JuanMShalvarez/IQ-TX/Hardware/Kicad Files/IQ_TX/MAX660CSA+.stp

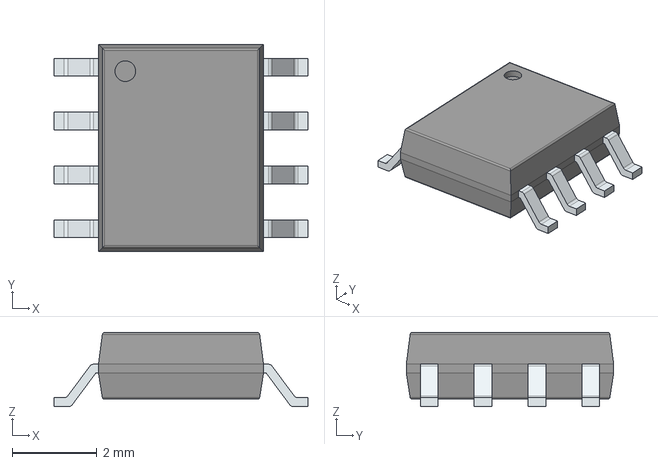
[picture p1: CAD file, 2026-11-06]
Hardware/Kicad Files/IQ_TX/MAX660CSA+.stp
6.00 x 4.90 x 1.75 mm
PinsArrayLR
