JuanMShalvarez/IQ-TX/Hardware/Kicad Files/IQ_TX/ADRF6755ACPZ.stp

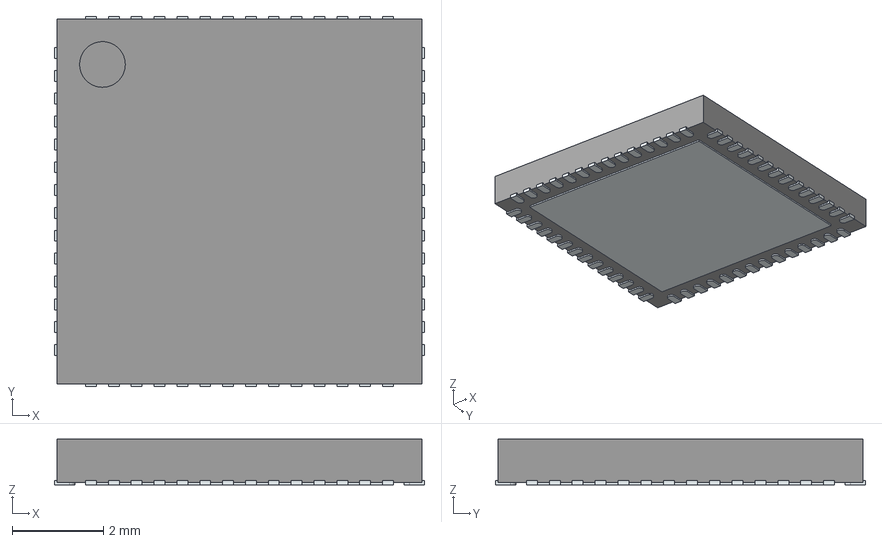
[picture p2: CAD file, 2026-11-06]
Hardware/Kicad Files/IQ_TX/ADRF6755ACPZ.stp
8.10 x 8.10 x 1.00 mm
ThermalPin
PinsArrayLR
PinsArrayTB
