JuanMShalvarez/IQ-TX/Hardware/Kicad Files/IQ_TX/SMARA_CONNECTOR.stp

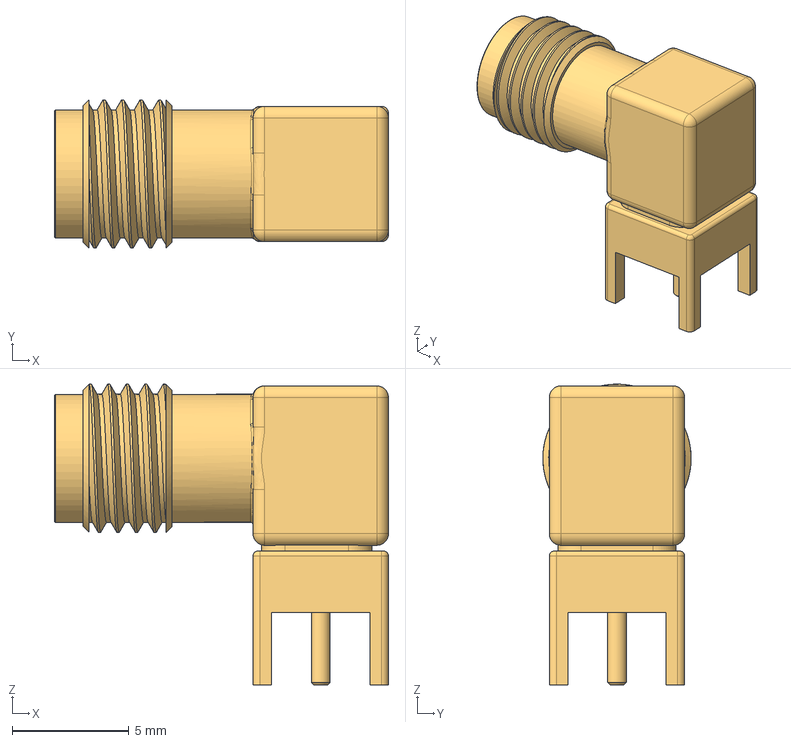
[picture p3: CAD file, 2026-11-06]
Hardware/Kicad Files/IQ_TX/SMARA_CONNECTOR.stp
14.3 x 6.35 x 12.9 mm
