JuanMShalvarez/IQ-TX/Hardware/Kicad Files/IQ_TX.kicad_pcb

## KiCad design Hardware/Kicad Files/IQ_TX.kicad_pcb (2026-10-28)

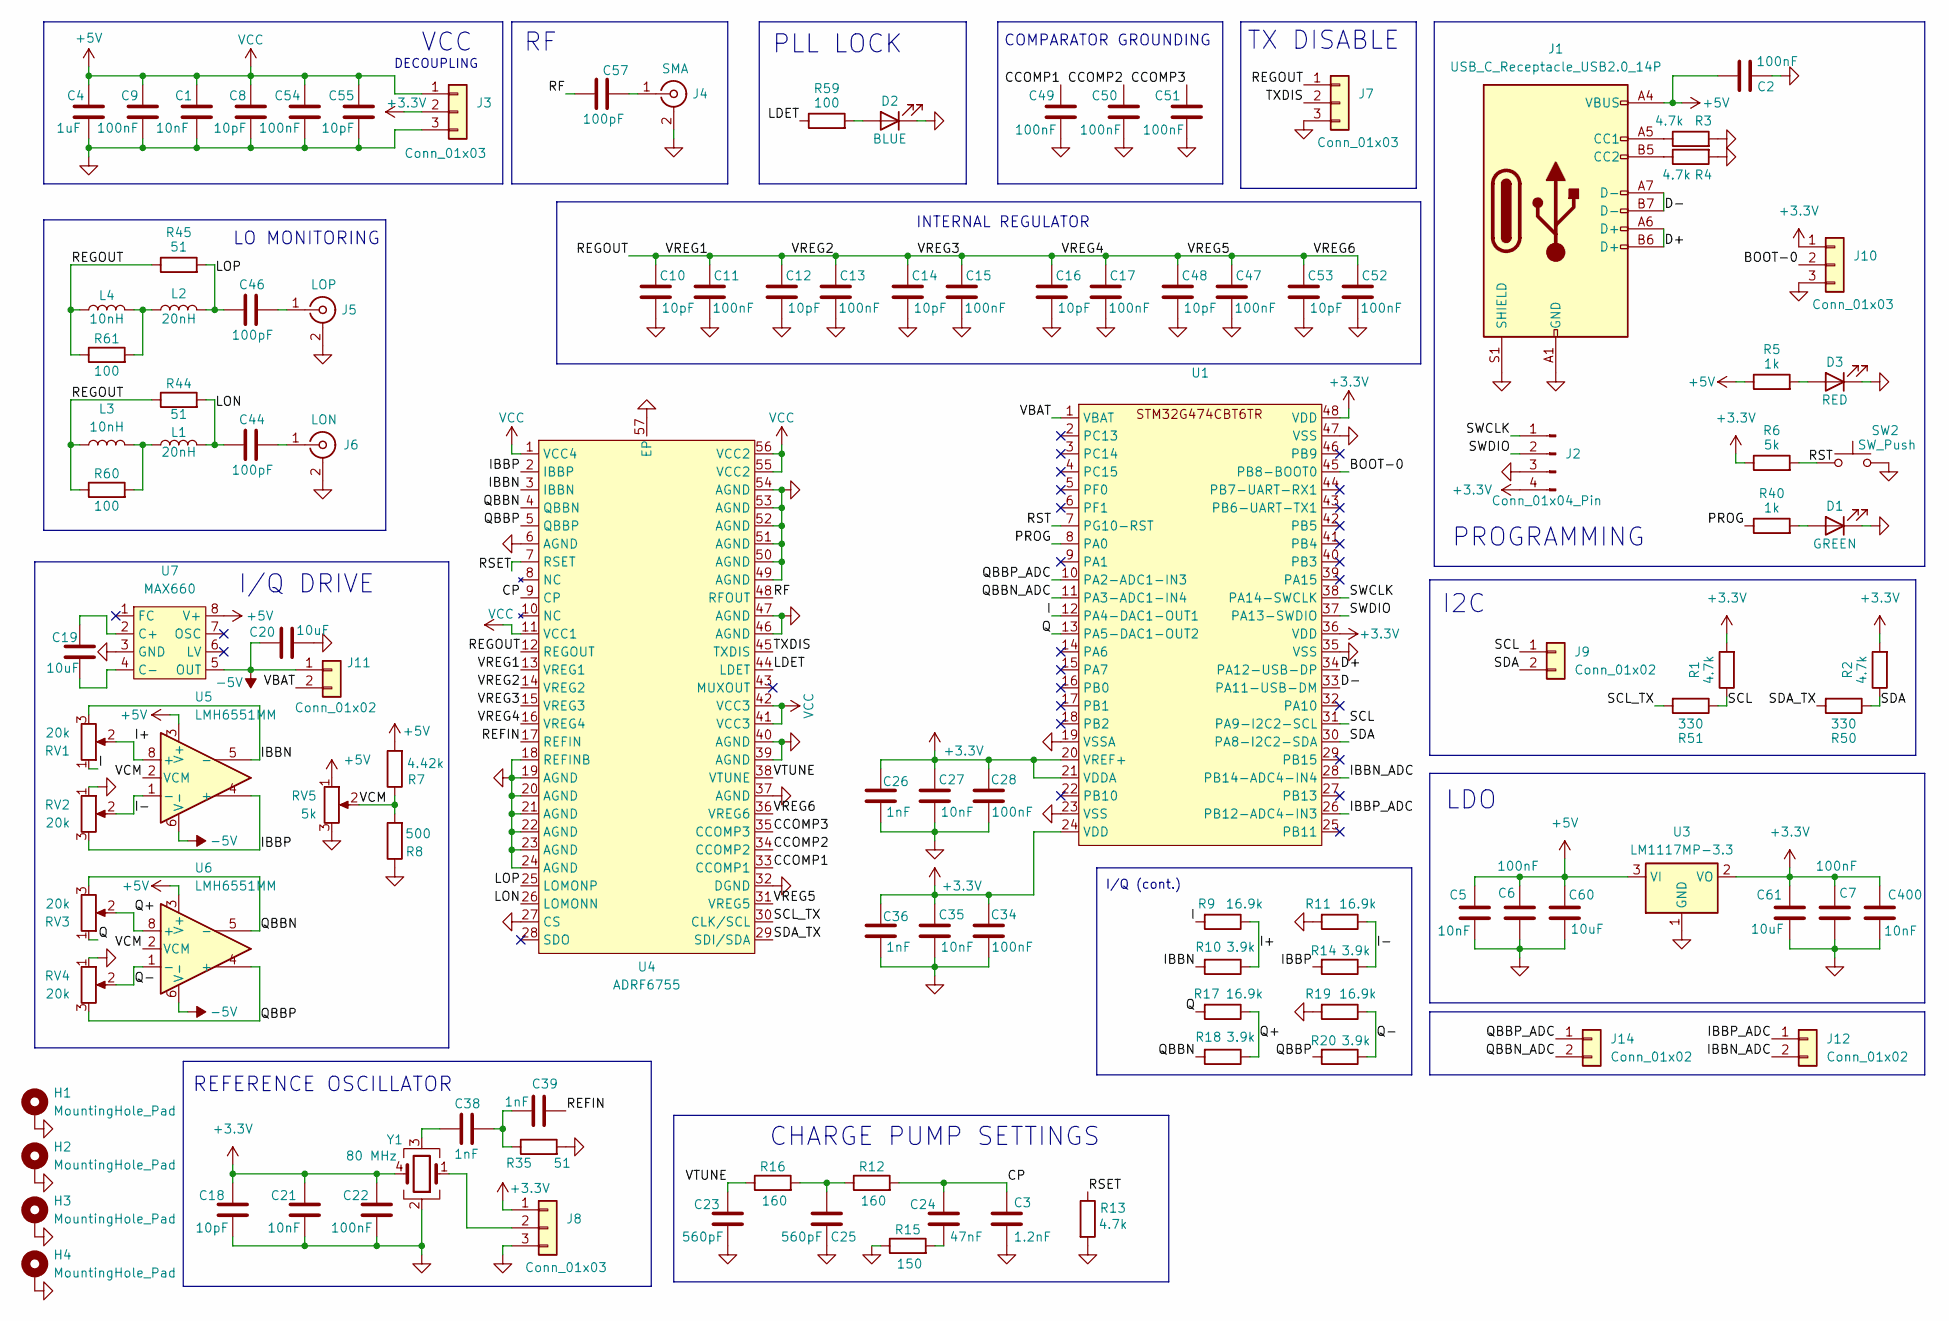
[picture p4: schematic IQ_TX.kicad_sch, I/Q TX Module]

Parts:
C1, C5, C21, C27, C35, C400: 10nF; C_0603_1608Metric
C2, C6, C7, C9, C11, C13, C15, C17, C22, C28, C34, C47, C49, C50, C51, C52, C54: 100nF; C_0603_1608Metric
C3: 1.2nF; C_0603_1608Metric
C4: 1uF; C_0603_1608Metric
C8, C10, C12, C14, C16, C18, C48, C53, C55: 10pF; C_0603_1608Metric
C19, C20: 10uF; C_0603_1608Metric
C23, C25: 560pF; C_0603_1608Metric
C24: 47nF; C_0603_1608Metric
C26, C36, C38, C39: 1nF; C_0603_1608Metric
C44, C46, C57: 100pF; C_0603_1608Metric
C60, C61: 10uF; CP_Elec_4x4.5
D1: GREEN; LED_0603_1608Metric
D2: BLUE; LED_0603_1608Metric
D3: RED; LED_0603_1608Metric
H1, H2, H3, H4: MountingHole_Pad; MountingHole_3.2mm_M3_Pad_Via
J1: USB_C_Receptacle_USB2.0_14P; USB_C_Receptacle_HRO_TYPE-C-31-M-12
J2: Conn_01x04_Pin; PinHeader_1x04_P2.54mm_Vertical
J3, J7, J8, J10: Conn_01x03; PinHeader_1x03_P2.54mm_Vertical
J4: SMA; SMA_Amphenol_901-144_Vertical
J5: LOP; SMA_Amphenol_901-144_Vertical
J6: LON; SMA_Amphenol_901-144_Vertical
J9, J11, J12, J14: Conn_01x02; PinHeader_1x02_P2.54mm_Vertical
L1, L2: 20nH; L_0603_1608Metric
L3, L4: 10nH; L_0603_1608Metric
R1, R2, R3, R4, R13: 4.7k; R_0603_1608Metric
R5, R40: 1k; R_0603_1608Metric
R6: 5k; R_0603_1608Metric
R7: 4.42k; R_0603_1608Metric
R8: 500; R_0603_1608Metric
R9, R11, R17, R19: 16.9k; R_0603_1608Metric
R10, R14, R18, R20: 3.9k; R_0603_1608Metric
R12, R16: 160; R_0603_1608Metric
R15: 150; R_0603_1608Metric
R35, R44, R45: 51; R_0603_1608Metric
R50, R51: 330; R_0603_1608Metric
R59, R60, R61: 100; R_0603_1608Metric
RV1, RV2, RV3, RV4: 20k; Potentiometer_Bourns_3386W_Horizontal
RV5: 5k; Potentiometer_Bourns_3386W_Horizontal
SW2: SW_Push; SW_Push_1P1T_XKB_TS-1187A
U1: LQFP-48_7x7mm_P0.5mm
U3: LM1117MP-3.3; SOT-223-3_TabPin2
U4: ADRF6755; LFCSP-56-1EP_8x8mm_P0.5mm_EP6.6x6.6mm
U5, U6: LMH6551MM; VSSOP-8_3x3mm_P0.65mm
U7: MAX660; SOP-8_3.76x4.96mm_P1.27mm
Y1: 80 MHz; Oscillator_SMD_EuroQuartz_XO32-4Pin_3.2x2.5mm

Connections:
+3.3V: C7.2, C18.2, C21.2, C22.2, C26.2, C27.2, C28.2, C34.2, C35.2, C36.2, C61.1, C400.2, J2.4, J3.2, J8.1, J10.1, R1.2, R2.2, R6.1, U1.20 (VREF+), U1.21 (VDDA), U1.24 (VDD), U1.36 (VDD), U1.48 (VDD), U3.2 (VO), Y1.4
+5V: C1.2, C2.2, C4.2, C5.2, C6.2, C8.2, C9.2, C54.2, C55.2, C60.1, J1.A4 (VBUS), J1.A9 (VBUS), J1.B4 (VBUS), J1.B9 (VBUS), J3.1, R5.1, R7.2, RV5.1, U3.3 (VI), U4.1 (VCC4), U4.11 (VCC1), U4.41 (VCC3), U4.42 (VCC3), U4.55 (VCC2), U4.56 (VCC2), U5.3 (V+), U6.3 (V+), U7.8 (V+)
-5V: C20.2, J11.1, U5.6 (V-), U6.6 (V-), U7.5 (OUT)
/BOOT-0: J10.2, U1.45 (PB8-BOOT0)
/CCOMP1: C49.2, U4.33 (CCOMP1)
/CCOMP2: C50.2, U4.34 (CCOMP2)
/CCOMP3: C51.2, U4.35 (CCOMP3)
/CP: C3.2, C24.2, R12.2, U4.9 (CP)
/D+: J1.A6 (D+), J1.B6 (D+), U1.34 (PA12-USB-DP)
/D-: J1.A7 (D-), J1.B7 (D-), U1.33 (PA11-USB-DM)
/I: R9.2, RV1.1, U1.12 (PA4-DAC1-OUT1)
/I+: R9.1, R10.1, RV1.2, U5.8 (+)
/I-: R11.1, R14.1, RV2.2, U5.1 (-)
/IBBN: R10.2, RV1.3, U4.3 (IBBN), U5.5 (-)
/IBBN_ADC: J12.2, U1.28 (PB14-ADC4-IN4)
/IBBP: R14.2, RV2.3, U4.2 (IBBP), U5.4 (+)
/IBBP_ADC: J12.1, U1.26 (PB12-ADC4-IN3)
/LDET: R59.1, U4.44 (LDET)
/LON: C44.1, L1.2, R44.2, U4.26 (LOMONN)
/LOP: C46.1, L2.2, R45.2, U4.25 (LOMONP)
/PROG: R40.1, U1.8 (PA0)
/Q: R17.2, RV3.1, U1.13 (PA5-DAC1-OUT2)
/Q+: R17.1, R18.1, RV3.2, U6.8 (+)
/Q-: R19.1, R20.1, RV4.2, U6.1 (-)
/QBBN: R18.2, RV3.3, U4.4 (QBBN), U6.5 (-)
/QBBN_ADC: J14.2, U1.11 (PA3-ADC1-IN4)
/QBBP: R20.2, RV4.3, U4.5 (QBBP), U6.4 (+)
/QBBP_ADC: J14.1, U1.10 (PA2-ADC1-IN3)
/REFIN: C39.1, U4.17 (REFIN)
/REGOUT: C10.2, C11.2, C12.2, C13.2, C14.2, C15.2, C16.2, C17.2, C47.2, C48.2, C52.2, C53.2, J7.1, L3.1, L4.1, R44.1, R45.1, R60.1, R61.1, U4.12 (REGOUT), U4.13 (VREG1), U4.14 (VREG2), U4.15 (VREG3), U4.16 (VREG4), U4.31 (VREG5), U4.36 (VREG6)
/RF: C57.1, U4.48 (RFOUT)
/RSET: R13.1, U4.7 (RSET)
/RST: R6.2, SW2.1, U1.7 (PG10-RST)
/SCL: J9.1, R1.1, R51.1, U1.31 (PA9-I2C2-SCL)
/SCL_TX: R51.2, U4.30 (CLK/SCL)
/SDA: J9.2, R2.1, R50.1, U1.30 (PA8-I2C2-SDA)
/SDA_TX: R50.2, U4.29 (SDI/SDA)
/SWCLK: J2.1, U1.38 (PA14-SWCLK)
/SWDIO: J2.2, U1.37 (PA13-SWDIO)
/TXDIS: J7.2, U4.45 (TXDIS)
/VBAT: J11.2, U1.1 (VBAT)
/VCM: R7.1, R8.2, RV5.2, U5.2 (VCM), U6.2 (VCM)
/VTUNE: C23.2, R16.1, U4.38 (VTUNE)
GND: C1.1, C2.1, C3.1, C4.1, C5.1, C6.1, C7.1, C8.1, C9.1, C10.1, C11.1, C12.1, C13.1, C14.1, C15.1, C16.1, C17.1, C18.1, C20.1, C21.1, C22.1, C23.1, C25.1, C26.1, C27.1, C28.1, C34.1, C35.1, C36.1, C47.1, C48.1, C49.1, C50.1, C51.1, C52.1, C53.1, C54.1, C55.1, C60.2, C61.2, C400.1, D1.1 (K), D2.1 (K), D3.1 (K), H1.1, H2.1, H3.1, H4.1, J1.A1 (GND), J1.A12 (GND), J1.B1 (GND), J1.B12 (GND), J1.S1 (SHIELD), J2.3, J3.3, J4.2 (Ext), J5.2 (Ext), J6.2 (Ext), J7.3, J8.3, J10.3, R3.2, R4.2, R8.1, R11.2, R13.2, R15.1, R19.2, R35.2, RV2.1, RV4.1, RV5.3, SW2.2, U1.19 (VSSA), U1.23 (VSS), U1.35 (VSS), U1.47 (VSS), U3.1 (GND), U4.6 (AGND), U4.18 (REFINB), U4.19 (AGND), U4.20 (AGND), U4.21 (AGND), U4.22 (AGND), U4.23 (AGND), U4.24 (AGND), U4.27 (CS), U4.32 (DGND), U4.37 (AGND), U4.39 (AGND), U4.40 (AGND), U4.46 (AGND), U4.47 (AGND), U4.49 (AGND), U4.50 (AGND), U4.51 (AGND), U4.52 (AGND), U4.53 (AGND), U4.54 (AGND), U4.57 (EP), U7.3 (GND), Y1.2
unnamed: C24.1, R15.2
unnamed: C25.2, R12.1, R16.2
unnamed: C38.1, C39.2, R35.1
unnamed: C38.2, Y1.3
unnamed: D1.2 (A), R40.2
unnamed: D2.2 (A), R59.2
unnamed: D3.2 (A), R5.2
unnamed: J1.A5 (CC1), R3.1
unnamed: J1.B5 (CC2), R4.1
unnamed: C57.2, J4.1 (In)
unnamed: C46.2, J5.1 (In)
unnamed: C44.2, J6.1 (In)
unnamed: J8.2, Y1.1
unnamed: L1.1, L3.2, R60.2
unnamed: L2.1, L4.2, R61.2
unnamed: C19.2, U7.2 (C+)
unnamed: C19.1, U7.4 (C-)

Notes on the sheet:
DECOUPLING
I/Q (cont.)
TX DISABLE
COMPARATOR GROUNDING
I/Q DRIVE
I2C
REFERENCE OSCILLATOR
PROGRAMMING
VCC
INTERNAL REGULATOR
PLL LOCK
CHARGE PUMP SETTINGS
LO MONITORING
LDO

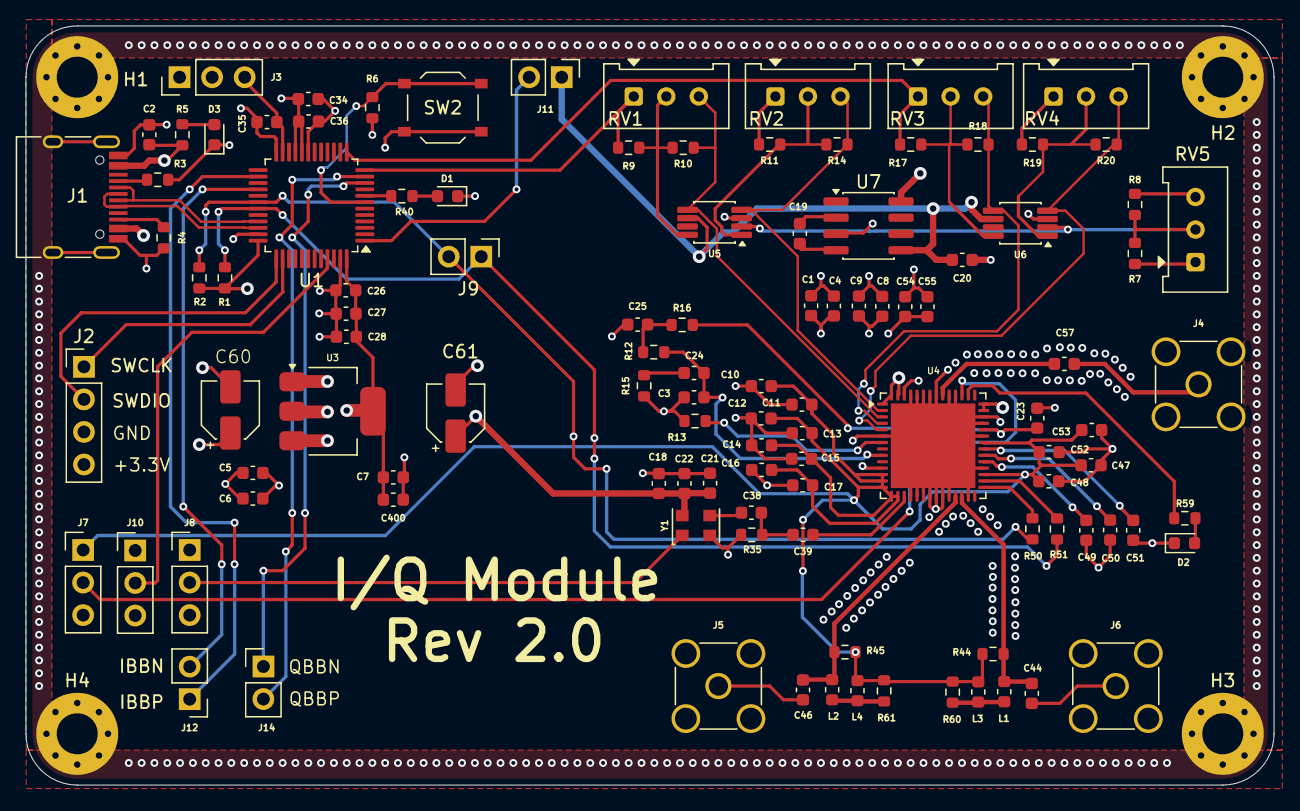
[picture p5: board IQ_TX.kicad_pcb from above]

Board: 4 copper layers, 97.4 x 59.2 mm, 114 parts (0 on the bottom side), 61 nets.
