JuanMShalvarez/IQ-TX/Firmware/IQ 2/Core/Src/main.c

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
/* Includes ------------------------------------------------------------------*/
#include "main.h"
#include "usb_device.h"

/* USER CODE BEGIN Includes */
#include <stdbool.h>
#include "usbd_cdc_if.h"

HAL_StatusTypeDef adrf6755_init(void);   // or put this in a header
void adrf6755_setFrequency(double MHz);
/* USER CODE END Includes */

DAC_HandleTypeDef hdac1;
DMA_HandleTypeDef hdma_dac1_ch1;

I2C_HandleTypeDef hi2c2;

TIM_HandleTypeDef htim6;

/* USER CODE BEGIN PV */
uint32_t dmaBuf[BUF_PAIRS];
volatile uint16_t wr = 0;
volatile uint8_t rx_stalled = 0;
extern USBD_HandleTypeDef hUsbDeviceFS;
/* USER CODE END PV */

void SystemClock_Config(void);
static void MX_GPIO_Init(void);
static void MX_DMA_Init(void);
static void MX_DAC1_Init(void);
static void MX_I2C2_Init(void);
static void MX_TIM6_Init(void);
/* USER CODE BEGIN 0 */

void blinkProgramLed(uint32_t delay_ms) {
	HAL_GPIO_WritePin(GPIOA, GPIO_PIN_0, GPIO_PIN_SET);
	HAL_Delay(delay_ms);
	HAL_GPIO_WritePin(GPIOA, GPIO_PIN_0, GPIO_PIN_RESET);
	HAL_Delay(delay_ms);
	HAL_GPIO_WritePin(GPIOA, GPIO_PIN_0, GPIO_PIN_SET);
}

uint16_t free_pairs(void) {
	uint16_t rd = BUF_PAIRS - __HAL_DMA_GET_COUNTER(hdac1.DMA_Handle1);
	return (rd - wr - 1) & (BUF_PAIRS - 1);
}

/* USER CODE END 0 */

/**
  * @brief  The application entry point.
  * @retval int
  */
int main(void)
{

  /* MCU Configuration--------------------------------------------------------*/

  /* Reset of all peripherals, Initializes the Flash interface and the Systick. */
  HAL_Init();

  /* Configure the system clock */
  SystemClock_Config();

  /* Initialize all configured peripherals */
  MX_GPIO_Init();
  MX_DMA_Init();
  MX_DAC1_Init();
  MX_I2C2_Init();
  MX_USB_Device_Init();
  MX_TIM6_Init();
  /* USER CODE BEGIN 2 */

	HAL_GPIO_WritePin(GPIOA, GPIO_PIN_0, GPIO_PIN_RESET);

	if (adrf6755_init() != HAL_OK) Error_Handler();
	adrf6755_setFrequency(500.0);

	HAL_Delay(1000);
	blinkProgramLed(200);

	if (HAL_DACEx_DualStart_DMA(&hdac1, DAC_CHANNEL_1, (uint32_t*)dmaBuf,
	                            BUF_PAIRS, DAC_ALIGN_8B_R) != HAL_OK) {
	    Error_Handler();
	}
	HAL_TIM_Base_Start(&htim6);

  /* USER CODE END 2 */

  /* Infinite loop */
  /* USER CODE BEGIN WHILE */
	while (1) {
    /* USER CODE END WHILE */

    /* USER CODE BEGIN 3 */
		if (rx_stalled && free_pairs() >= 32) {
			rx_stalled = 0;
			USBD_CDC_ReceivePacket(&hUsbDeviceFS);
		}
	}
  /* USER CODE END 3 */
}

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
