JuanMShalvarez/IQ-TX/Firmware/IQ 2/IQ 2.ioc

Mcu.UserName=STM32G474CBTx
PA0.Signal=GPIO_Output
PA11.Signal=USB_DM
PA12.Signal=USB_DP
PA4.Signal=COMP_DAC11_group
PA5.Signal=COMP_DAC12_group
PA8.Signal=I2C2_SDA
PA9.Signal=I2C2_SCL
