JuanMShalvarez/IQ-TX/(notices)

Notices in the files:
Firmware/IQ 2/Core/Src/main.c:
Copyright (c) 2026 STMicroelectronics.
All rights reserved.
This software is licensed under terms that can be found in the LICENSE file
